OneArgo/ArgoTechCoP/meeting_notes/virtual_meeting_1_notes_20250226.md

Hello Argo Tech Community, 

Please note that you are receiving this email through argo-tech@groups.wmo.int, which is a combination of previously existing emails on the list and emails added from the Argo Tech workshop held at University of Washington in September of last year. If you do not wish to receive emails as part of this list, I believe you should be able to unsubscribe at the bottom. If not, feel free to email me at chris.gordon@dfo-mpo.gc.ca and I will take care of it. 

Hope everyone has been well since our in-person workshop in September. Please join us for a virtual meeting on February 27 at 2200 UTC where we will discuss the following: 

1. Review and finalize meeting report from the Argo Tech Workshop, to be presented at the Argo Steering Team meeting (26th Argo Steering Team Meeting (AST-26) | Argo)
2. Proposal and technical requirements for a “default” Argo profile
3. Setting date and topic for our next virtual meeting

I will circulate the meeting report for comment by the end of next week. If there is a topic you would like to discuss or present on at this meeting or a subsequent virtual meeting please reach out. 

Thanks,
Chris
