OneArgo/ArgoTechCoP/deployment_procedures/Salzig_3D_printed_water_release/STEP_files/water_release_V8_pin.stp

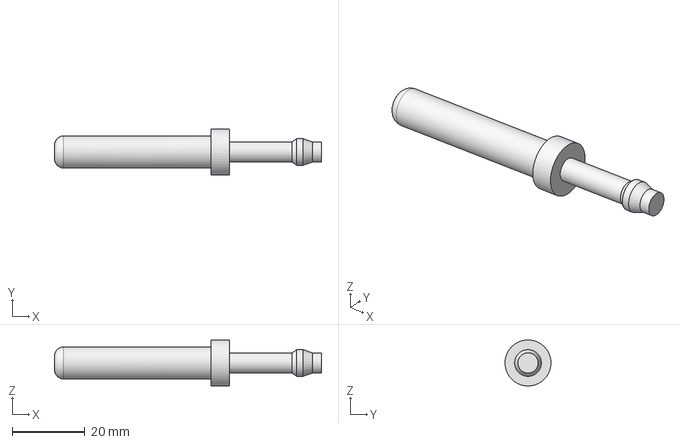
[picture p23: CAD file, 2026-10-01]
deployment_procedures/Salzig_3D_printed_water_release/STEP_files/water_release_V8_pin.stp
73.7 x 12.7 x 12.7 mm
