OneArgo/ArgoTechCoP/deployment_procedures/Salzig_3D_printed_water_release/STEP_files/water_release_V8_frame.stp

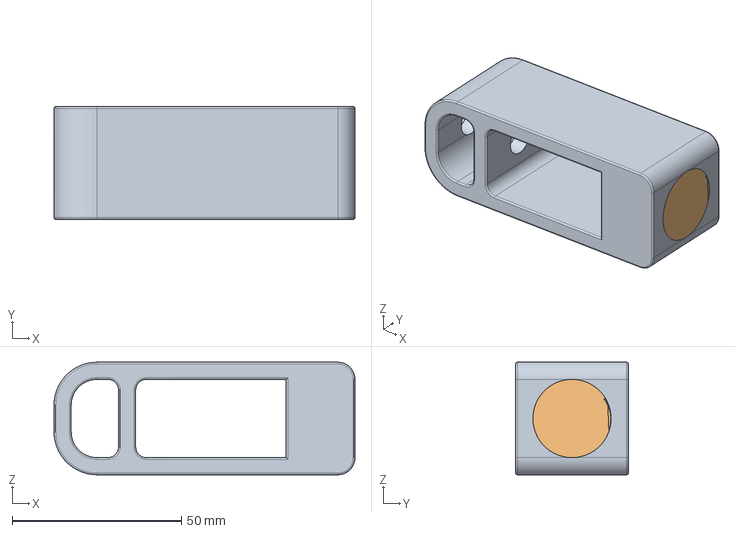
[picture p24: CAD file, 2026-10-01]
deployment_procedures/Salzig_3D_printed_water_release/STEP_files/water_release_V8_frame.stp
88.9 x 33.3 x 33.3 mm
