OneArgo/ArgoTechCoP/deployment_procedures/Salzig_3D_printed_water_release/STEP_files/water_release_V8_screw.stp

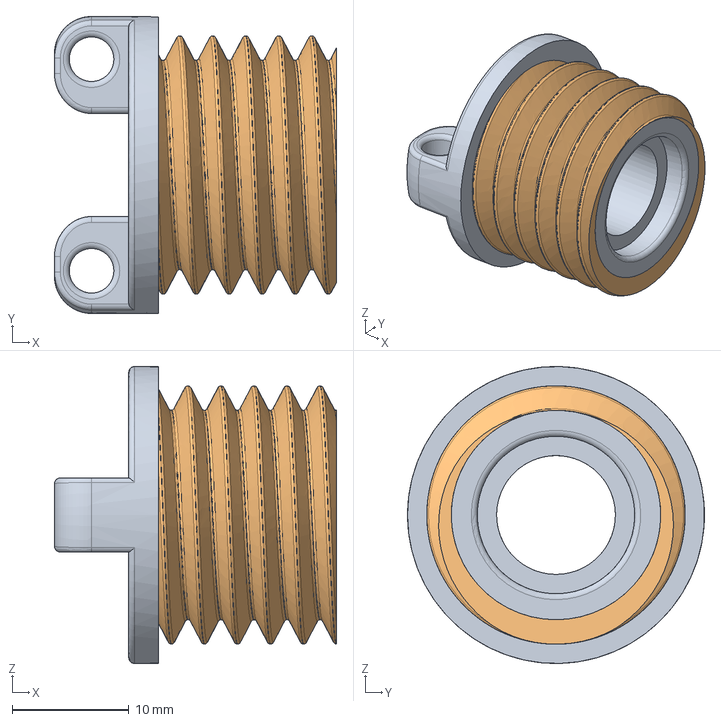
[picture p25: CAD file, 2026-10-01]
deployment_procedures/Salzig_3D_printed_water_release/STEP_files/water_release_V8_screw.stp
24.1 x 25.4 x 25.4 mm
