OneArgo/ArgoTechCoP/(list of files, cad)

Other CAD files:
deployment_procedures/Salzig_3D_printed_water_release/drawing_files/water_release_V8_frame.dwg
deployment_procedures/Salzig_3D_printed_water_release/drawing_files/water_release_V8_pin.dwg
deployment_procedures/Salzig_3D_printed_water_release/drawing_files/water_release_V8_screw.dwg
deployment_procedures/Salzig_3D_printed_water_release/Autodesk_Inventor_files/9657K352_Compression Spring.ipt
deployment_procedures/Salzig_3D_printed_water_release/Autodesk_Inventor_files/starch_collar.ipt
deployment_procedures/Salzig_3D_printed_water_release/Autodesk_Inventor_files/water_release_V8_assembly.iam
deployment_procedures/Salzig_3D_printed_water_release/Autodesk_Inventor_files/water_release_V8_frame.ipt
deployment_procedures/Salzig_3D_printed_water_release/Autodesk_Inventor_files/water_release_V8_pin.ipt
deployment_procedures/Salzig_3D_printed_water_release/Autodesk_Inventor_files/water_release_V8_screw.ipt
deployment_procedures/Salzig_3D_printed_water_release/STL_files/water_release_V8_frame.stl
deployment_procedures/Salzig_3D_printed_water_release/STL_files/water_release_V8_pin.stl
deployment_procedures/Salzig_3D_printed_water_release/STL_files/water_release_V8_screw.stl
