OneArgo/ArgoTechCoP/deployment_procedures/Salzig_3D_printed_water_release/destructive_testing/ASA Water Release test.pdf

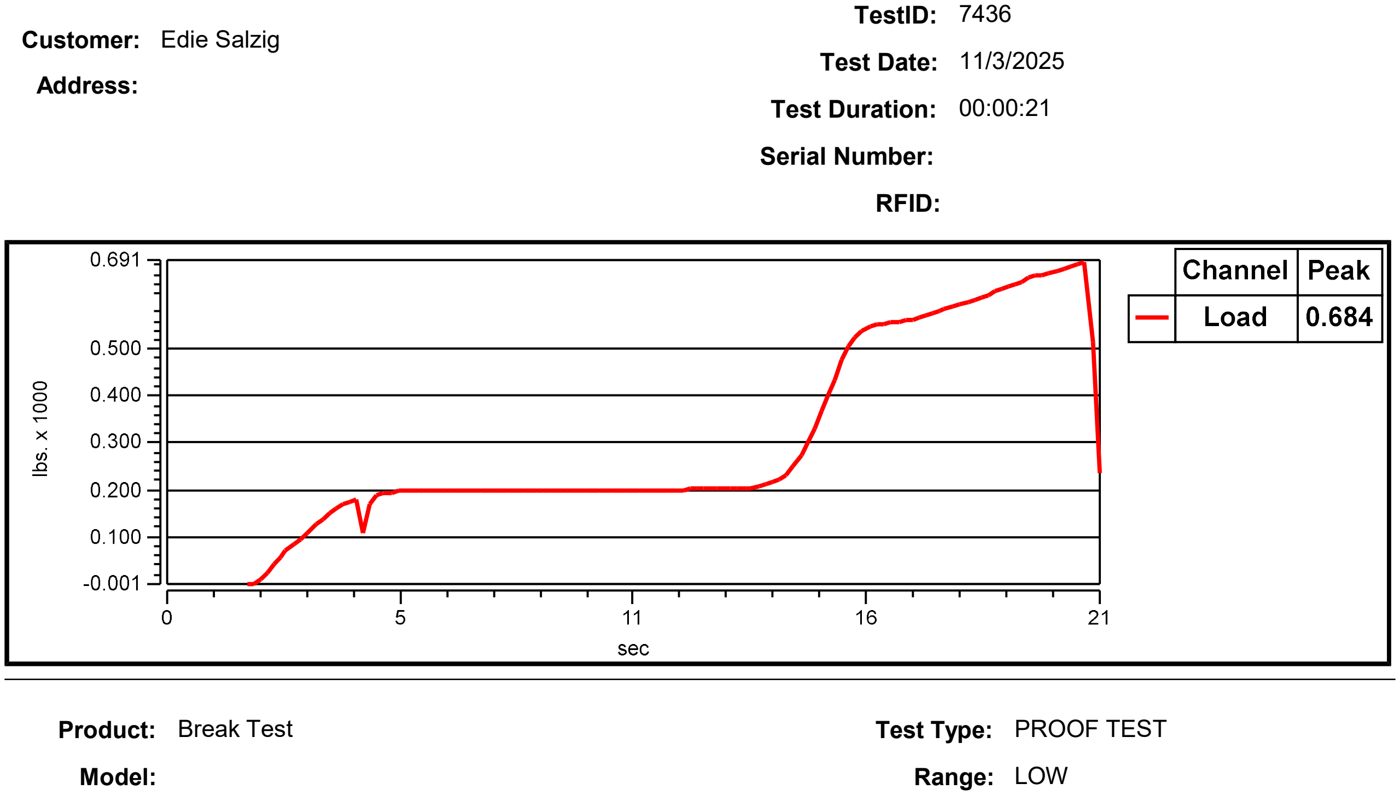
[picture p35: figure]
Range: LOW; Test Type: PROOF TEST; Model:; Product: Break Test; Address:; Customer: Edie Salzig; TestID: 7436; Test Date: 11/3/2025; Serial Number:; Test Duration: 00:00:21; RFID:

Operator Chris Ross

Material ASA Water Release

Notes

Proof Load:

WLL:

Size:

Length:

Description:

Load Rate: 0.033 kips/sec

Number of Cycles: 1

Completion Load: 0 lbs x 1000

Lower Hold Time: 0 sec

Lower Limit: 0 lbs x 1000

Upper Hold Time: 60 sec

Upper Limit: 2 lbs x 1000

# CERTIFICATE OF TESTING

These products have had a load applied to them in conformance with the customer's specifications. There is no warranty, expressed or implied, by the test machine manufacturer that these goods are suitable for a purpose or use.
