OneArgo/ArgoTechCoP/(threads)

Thread 1 (2025-04-07):

Track action items from the Argo Tech workshop and beyond in a github repo

cgrdn, 2025-04-07:
Model after the ADMT action item dashboard ([All ADMT actions · ADMT - actions dashboard](https://github.com/orgs/OneArgo/projects/1)). Check with ADMT co-chairs if it would be preferable for Argo Tech to host their own organization or if it would be more appropriate to set it up under the OneArgo github organization.

cgrdn, 2025-04-07:
Discussed with @mscanderbeg that OneArgo org would be appropriate place for this repo. Creation of this issue and the ones to follow represents the completion of the action item, but I will leave it open until at least after AST.

Thread 11 (2025-04-07):

Include humidity sensors in floats for leak detection.

cgrdn, 2025-04-07:
Not all floats are equipped with humidity sensors for leak detection. All vendors plan to release controllers with humidity sensors on next generation floats to enhance leak diagnosis and failure analysis.

Thread 12 (2025-04-07):

Float depth control and pressure sensor requirements for end of life.

cgrdn, 2025-04-07:
All manufacturers can send commands to keep a float at depth, however some floats require a functional pressure sensor to leave the surface. Argo Tech requests all floats be capable of being sent below the surface for end of life in the event of CTD sensor failure.

Thread 14 (2025-04-07):

Results for a zero frequency test stored on board SBS CTD sensors in the same way as calibration coefficients

cgrdn, 2025-04-07:
Additionally, Argo Tech requests the 0 frequency test data be stored in SeaBird onboard float information, and that the 0 frequency test can be easily re-run through connection to the float, perhaps as part of the default self test. It should be noted however that this test would fail if the CTD is wet.

Thread 16 (2025-04-07):

Temperature tracking throughout shipping.

cgrdn, 2025-04-07:
Due to shipping in IDLE (pressure-activation) state, TWR APEX floats periodically check pressure and temperature. The data is stored on board and accessible by the end user, resulting in a temperature record throughout the shipping process. Argo Tech would request this from other vendors as well as it could be a useful diagnostic record. SBS noted a desired temperature during shipping <45°C; there is currently no way to evaluate how many sensors may be experiencing those temperatures prior to deployment across the whole array.

Thread 17 (2025-04-07):

Enhanced language surrounding float performance.

cgrdn, 2025-04-07:
Argo Tech encourages members of the Argo community to carefully frame discussion of float failure. Keep in mind complimentary metrics like cost per profile or data when appropriate. Additionally, floats that last their expected lifetime and reach end of life though battery exhaustion should not be considered “failures”.

Thread 18 (2025-04-07):

Ability to check voltage on individual battery packs without opening the float on future platforms or alternative method to verify all packs are connected to the controller

cgrdn, 2025-04-07:
Verifying voltage on each pack ensures floats are not deployed with any bad batteries, reducing uncertainty when a float does not reach its expected number of profiles and allowing failures to be caught and rectified before deployment.

Thread 20 (2025-04-07):

User groups will use ticketing systems provided by vendors for all float issues. Manufacturers will ensure their responsiveness.

cgrdn, 2025-04-07:
User groups, especially those with close relationships with float vendors or sensor manufacturers, will often bypass the typical customer service portals these companies have in place in favor of direct contact with a representative they may have a personal relationship with. Bypassing these types of ticketing systems however can lead to issues not being properly tracked internally by the vendors.

User groups should be motivated to use these ticketing systems as it is the best way for vendors to track issues, and make changes to their products based on that information. It is a way for both end users and vendors to contribute to the progress/reliability of a given float/sensor.

On the manufacturer's side, reliability of these generalized email addresses will help in ensuring widespread adoption by users, as quicker, more reliable responses from personal connection discourages use of the ticketing system.

Overall, a mix of emailing manufacturers directly and copying their general support email is the suggested practice that should satisfy all parties.

Thread 6 (2025-04-07):

Enhance understanding of float failure modes.

cgrdn, 2025-04-07:
Larger user groups should track float failures and present analysis at bi-annual Argo Tech meetings and/or updates at quarterly virtual meetings (see SIO failure analysis presentation as an example). Any systematic failures should be communicated to the vendors and the Argo Tech group to prevent deployment of compromised floats.

RomainCancouet, 2025-06-05:
There is a vocab collection aimed at describing the reason(s) why a float has became inactive. See https://github.com/OneArgo/ArgoVocabs/issues/26 discussion and the [current version of the vocab](https://docs.google.com/document/d/1W1GpAei-Pz5WE-LC5VREFhKGJsenkDPV0GqPG6nimGU/edit?usp=sharing) (to be transferred on the NVS soon). We've provided such metadata (at OceanOPS, and soon in the meta file) for all Euro-Argo floats that became inactive between 2021 and 2024, and the intent is to go on each year. This metadata is useful when carrying out failure modes analysis, float performances/lifetimes etc.

Thread 7 (2025-04-07):

Improve fault identification and record-keeping.

cgrdn, 2025-04-07:
This action item is a call for improved record keeping prior to float deployment. This includes logging all interactions with the float, for example using date-stamped terminal logs. In addition, any problems discovered during float testing/ballasting/assembly should be formally recorded by the end user and shared with the vendor, even in cases where the problem can be fixed without any required RMA or similar action from vendors. WHOI maintains a github for this type of information, which is a good example to follow.

Thread 8 (2025-04-07):

Map appropriate float parameters to meta file variables, manufacturers and users log during checks.

cgrdn, 2025-04-07:
Float parameters that directly map to parameters in Argo meta files should be included in float check logs as well, by the manufacturer and/or in the log created by the user during testing. Argo Tech will work with manufacturers to map the language of these parameters to Argo parameter names across different platforms.

This action is complementary to the ADMT action [#26](https://github.com/OneArgo/ADMT/issues/26) to _make sensor parameters/calibration coefficients machine-readable via JSON file._ See more here: [euroargodev/sensor_metadata_json at dev/0.4.0](https://github.com/euroargodev/sensor_metadata_json)
