OneArgo/ArgoTechCoP/deployment_procedures/Salzig_3D_printed_water_release/drawing_files/water_release_V8_frame.pdf

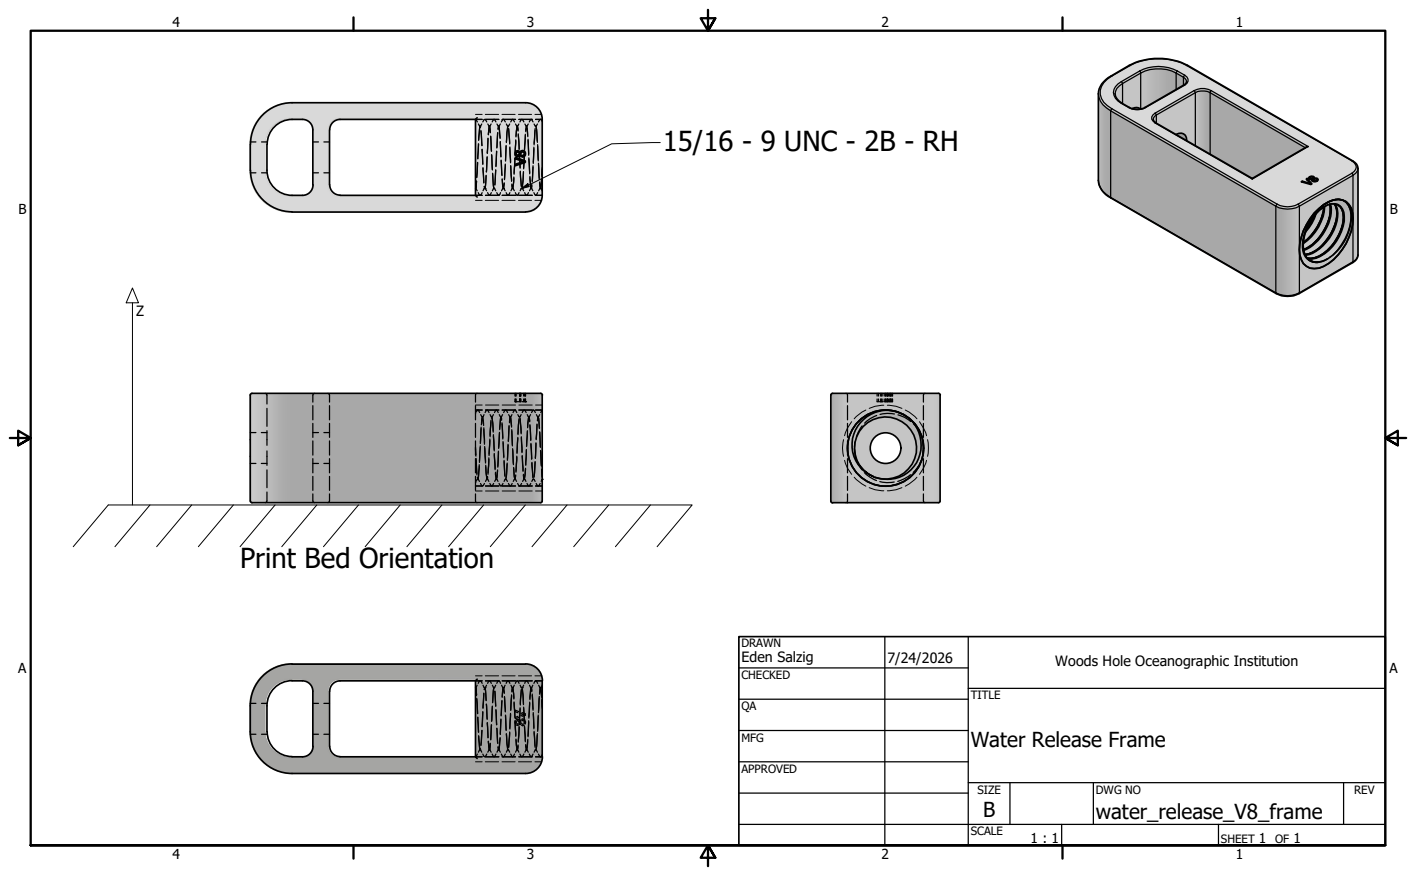
[picture p36: page 1]
15/16 - 9 UNC - 2B - RH

Print Bed Orientation

DRAWN Eden Salzig | 7/24/2026 | Woods Hole Oceanographic Institution

CHECKED

MFG

Water Release Frame

APPROVED

SIZE B | DWG NO water_release_V8_frame | REV

SCALE 1 : 1 | | SHEET 1 OF 1
