OneArgo/ArgoTechCoP/deployment_procedures/Salzig_3D_printed_water_release/drawing_files/water_release_V8_pin.pdf

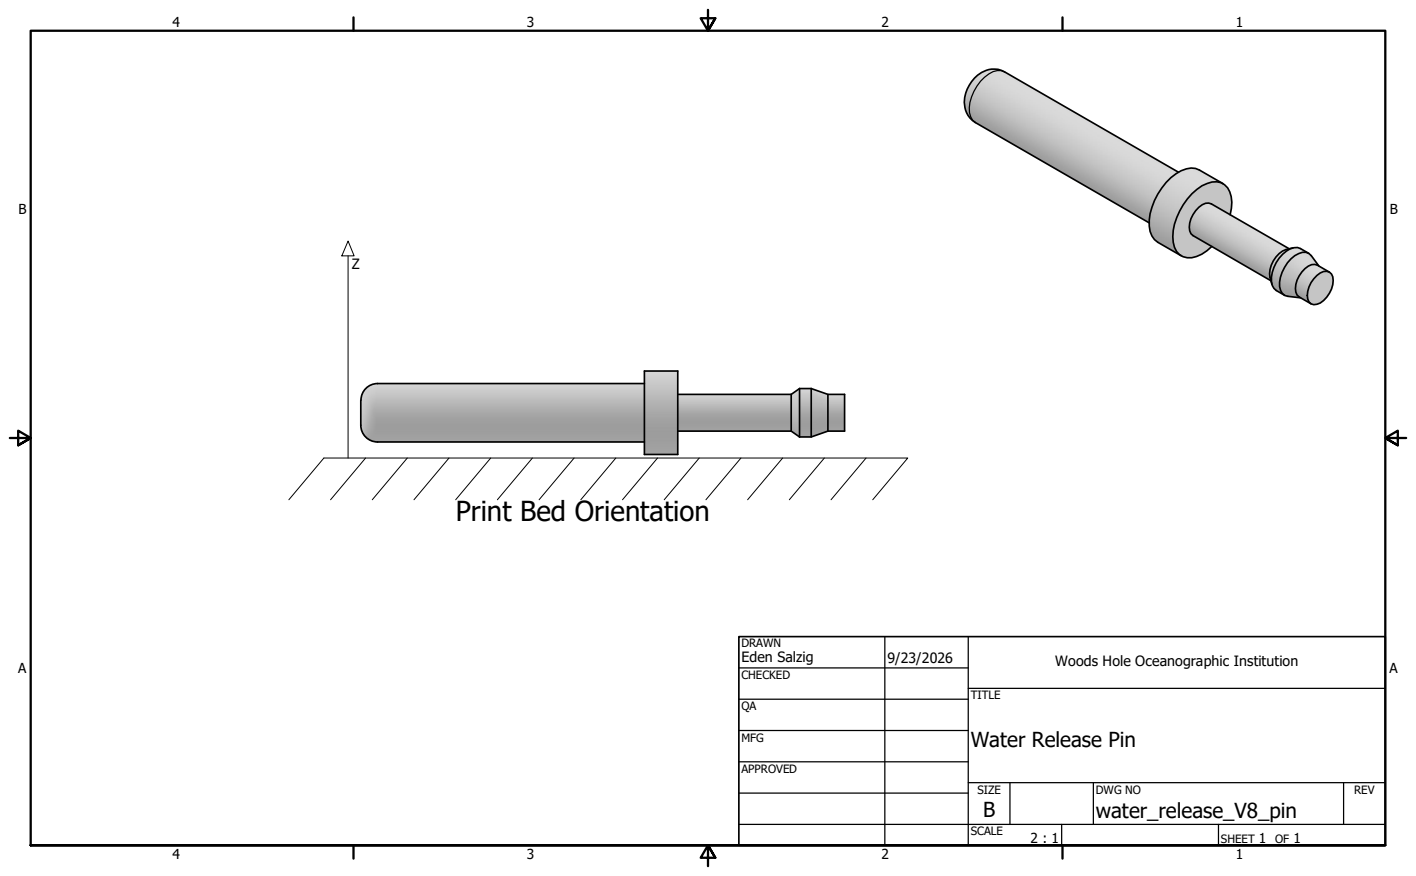
[picture p37: page 1]

Print Bed Orientation

DRAWN Eden Salzig | 9/23/2026 | Woods Hole Oceanographic Institution

CHECKED

MFG

Water Release Pin

APPROVED

SIZE B | DWG NO water_release_V8_pin | REV

SCALE 2 : 1 | | SHEET 1 OF 1
