OneArgo/ArgoTechCoP/deployment_procedures/Salzig_3D_printed_water_release/drawing_files/water_release_V8_screw.pdf

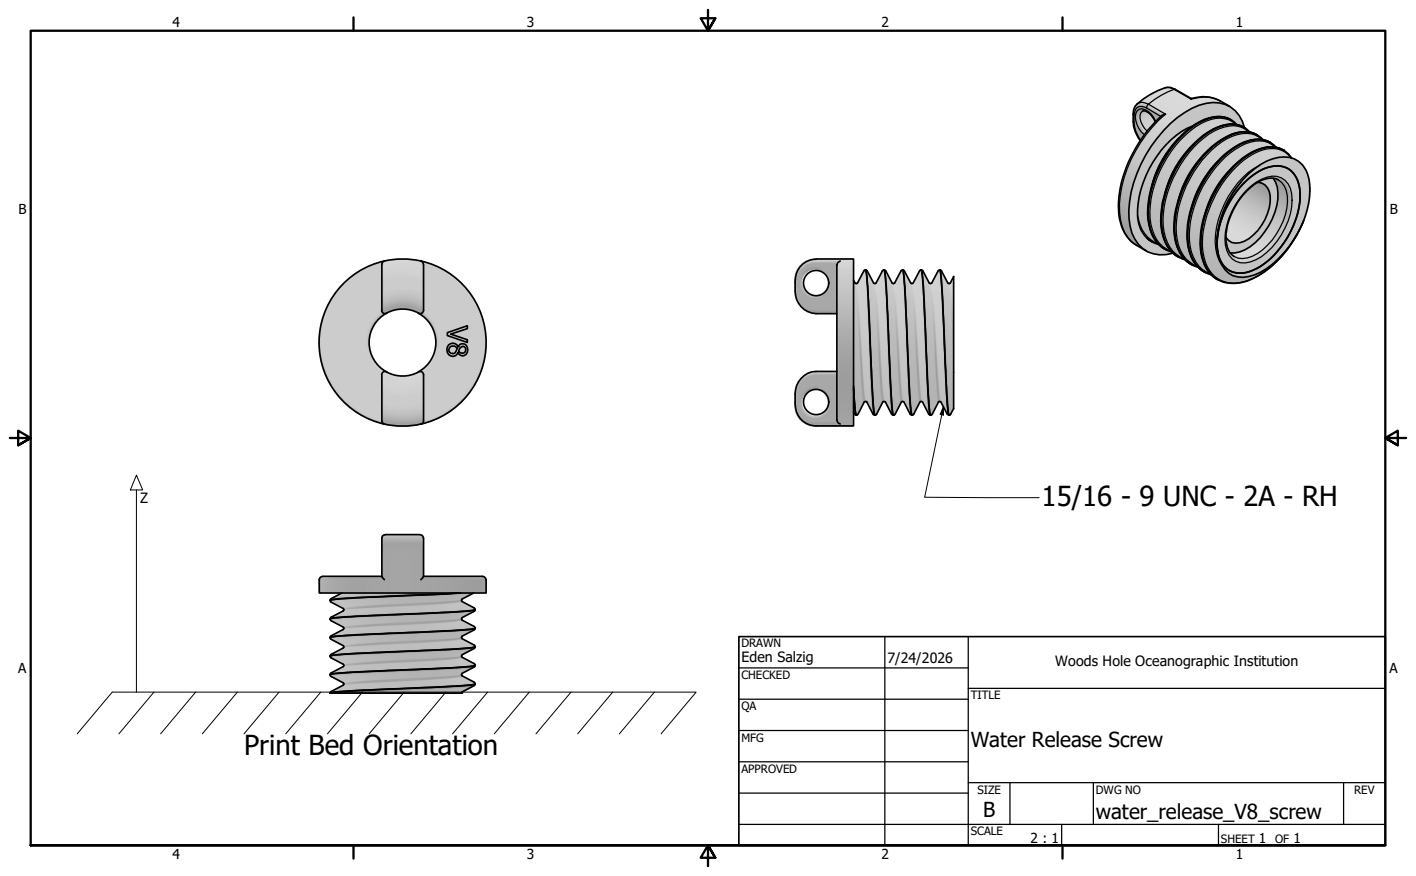
[picture p38: page 1]
15/16 - 9 UNC - 2A - RH

DRAWN Eden Salzig | 7/24/2026 | Woods Hole Oceanographic Institution

CHECKED

Print Bed Orientation

MFG

Water Release Screw

APPROVED

SIZE B | DWG NO water_release_V8_screw | REV

SCALE 2 : 1 | | SHEET 1 OF 1
